PeriwalPratham/VectorX/About Team/Swasti Kedia.md

# Swasti Kedia

<p align="center">
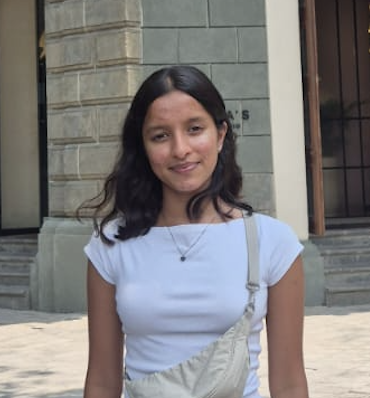
[picture p26: About Team/Swasti Kedia.png]
Swasti Kedia
  
</p>

## About Me
I am a 14-year old, Class 10 student at Podar International School, Powai (CBSE). I enjoy playing the piano, practicing martial arts, reading books, running & exploring new fields. I love building things & doing hands-on work, which led me to robotics.

**Role -** Code Lead
