PeriwalPratham/VectorX/About Team/Inaaya Sood.md

 # Inaaya Sood

<p align="center">
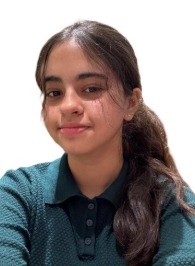
[picture p27: About Team/Inaaya Sood.png]
Inaaya Sood
  
</p>

## About Me
I am a **14-year-old Class 9 student** at **SVKM JV Parekh International School** with a strong passion for **robotics, programming, and engineering**. I enjoy **reading, coding, painting, and 3D designing**, and I am always eager to explore new technologies and develop innovative solutions.

I love experimenting with new code, building hands-on projects, and transforming ideas into functional designs. Whether I am programming autonomous robots, creating CAD models, or solving engineering challenges, I enjoy combining creativity with logical thinking to design practical and efficient solutions.

I believe that every project is an opportunity to learn something new, and I am constantly looking for ways to improve my technical skills and broaden my understanding of robotics and automation.

**Role -** Computer Vision Lead
