PeriwalPratham/VectorX/Cad/cad-iteration1.jpeg

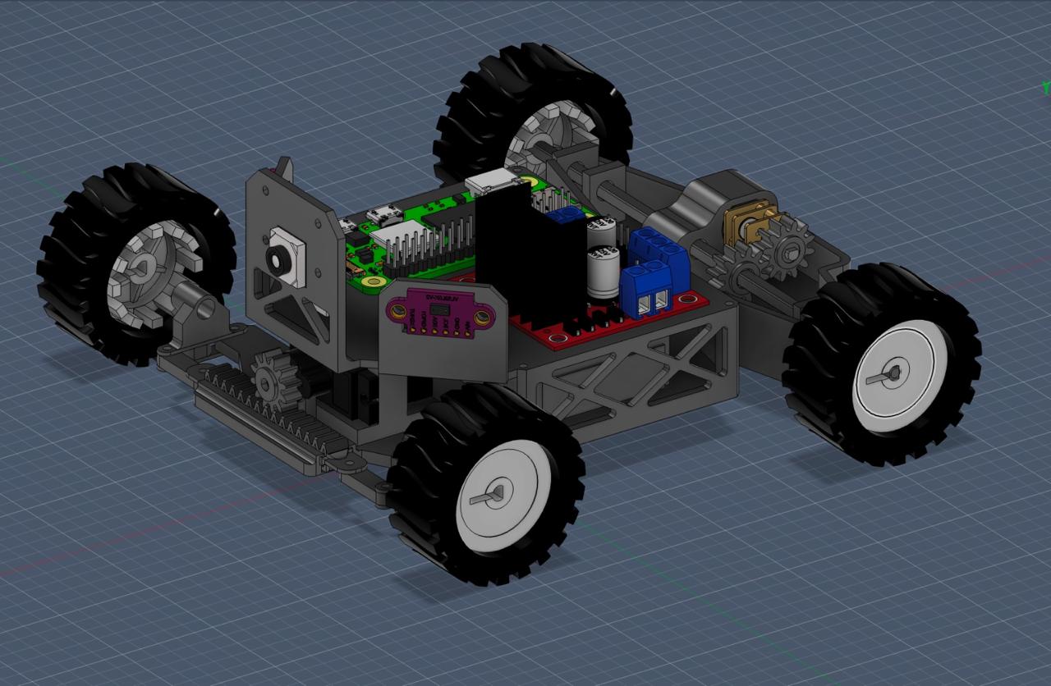
Cad/cad-iteration1.jpeg
