PeriwalPratham/VectorX/Cad/cad-iteration2.jpeg

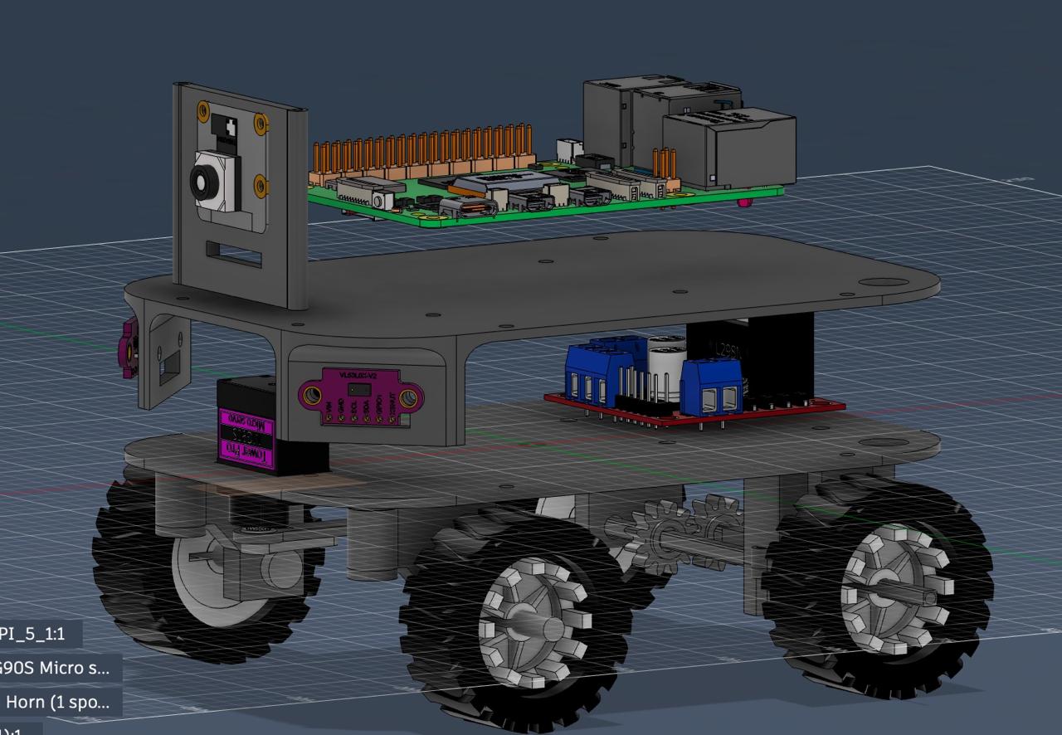
Cad/cad-iteration2.jpeg
