PeriwalPratham/VectorX/Cad/cad-iteration4.jpg

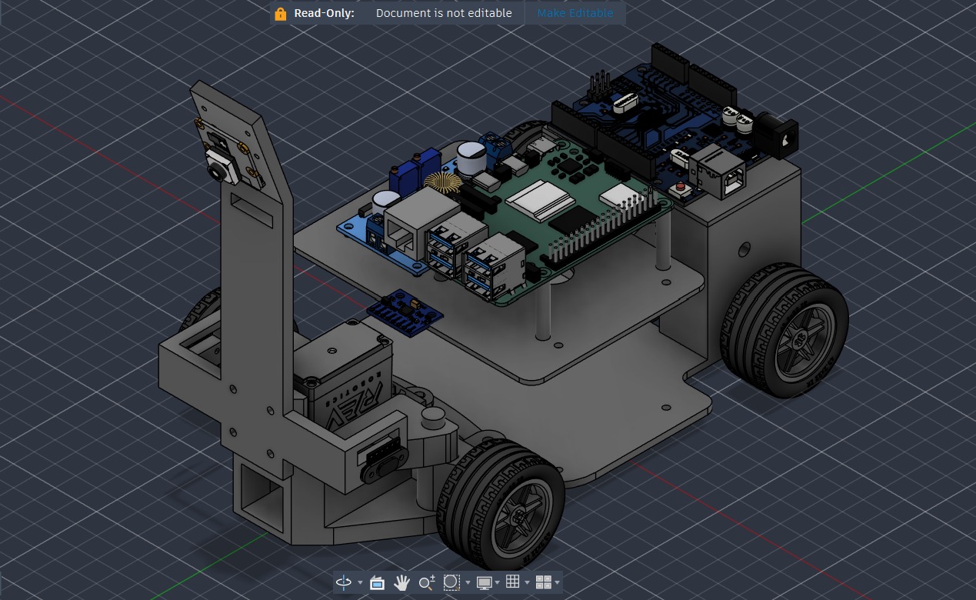
Cad/cad-iteration4.jpg
