PeriwalPratham/VectorX/Cad/cad-iteration4.png

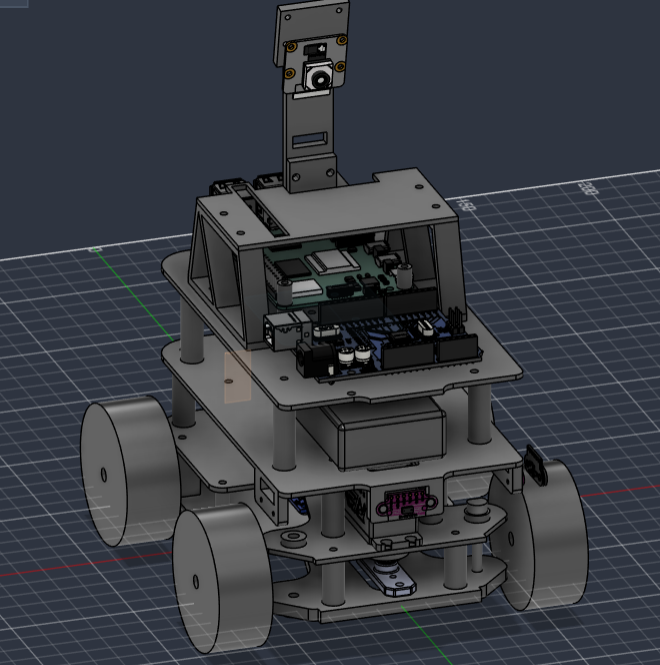
Cad/cad-iteration4.png
