PeriwalPratham/VectorX/Robot Photos/Back View APAC.png

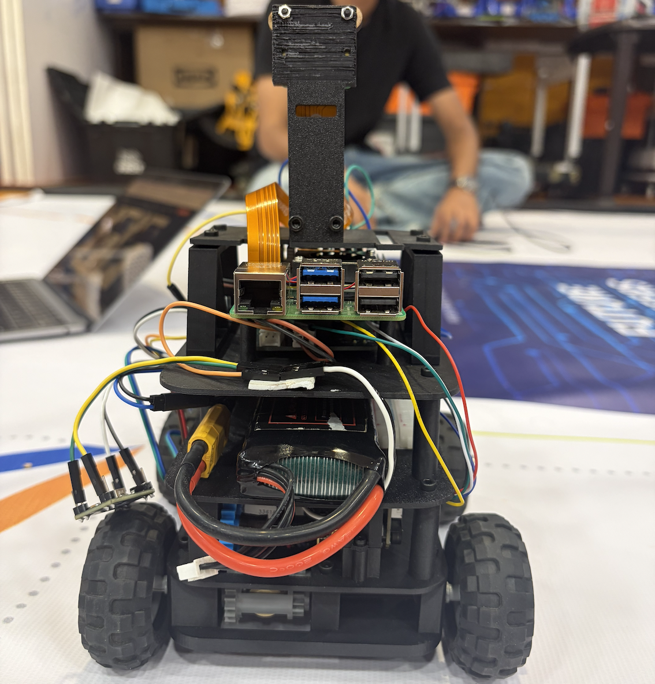
Robot Photos/Back View APAC.png
