PeriwalPratham/VectorX/Robot Photos/Bottom View APAC.png

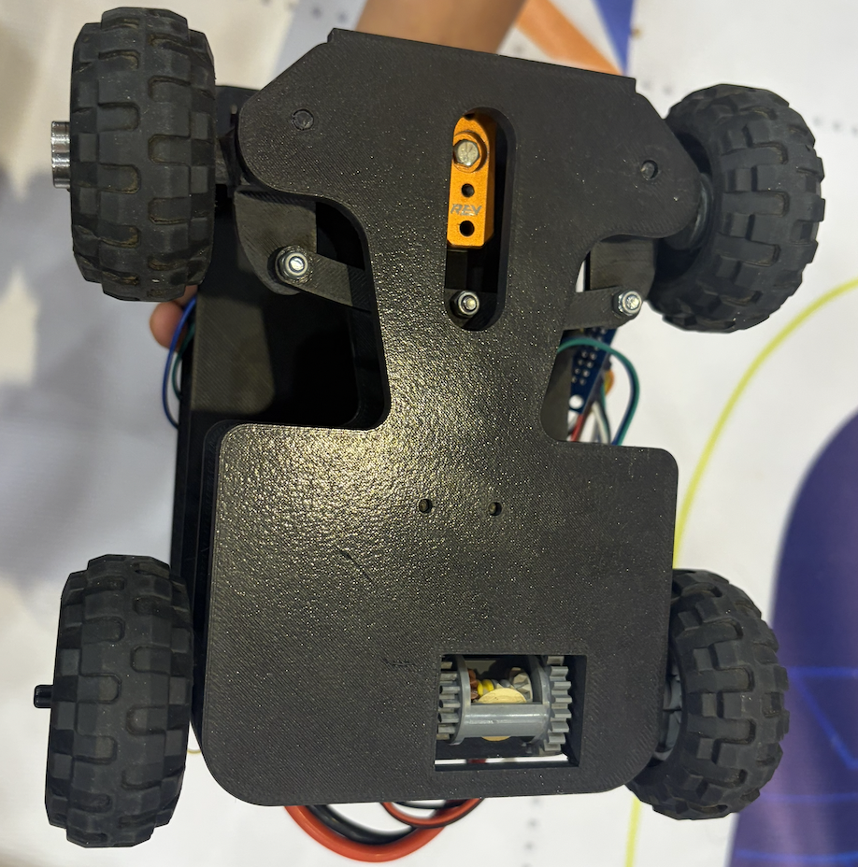
Robot Photos/Bottom View APAC.png
