PeriwalPratham/VectorX/Robot Photos/Front View APAC.png

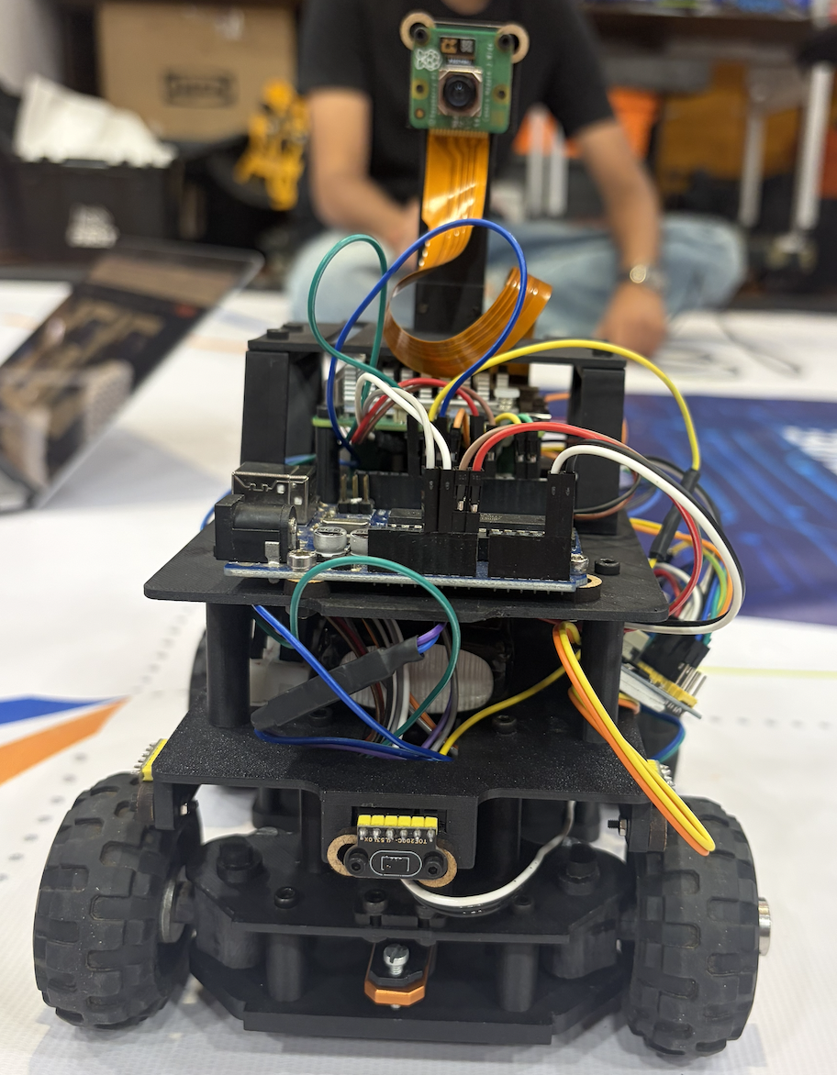
Robot Photos/Front View APAC.png
