PeriwalPratham/VectorX/Robot Photos/Left View APAC.png

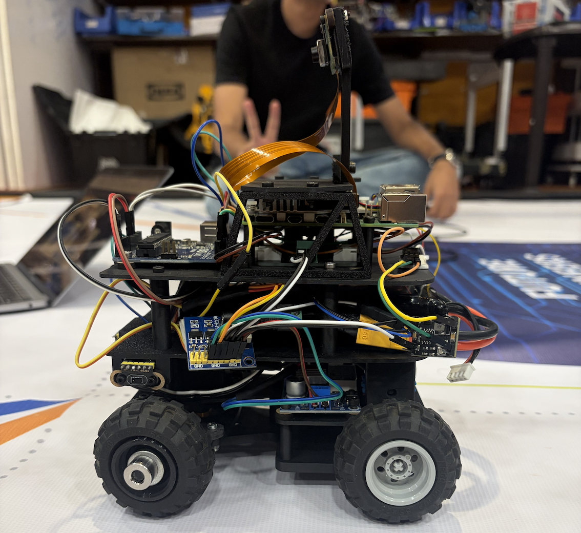
Robot Photos/Left View APAC.png
