PeriwalPratham/VectorX/Robot Photos/Right View APAC.png

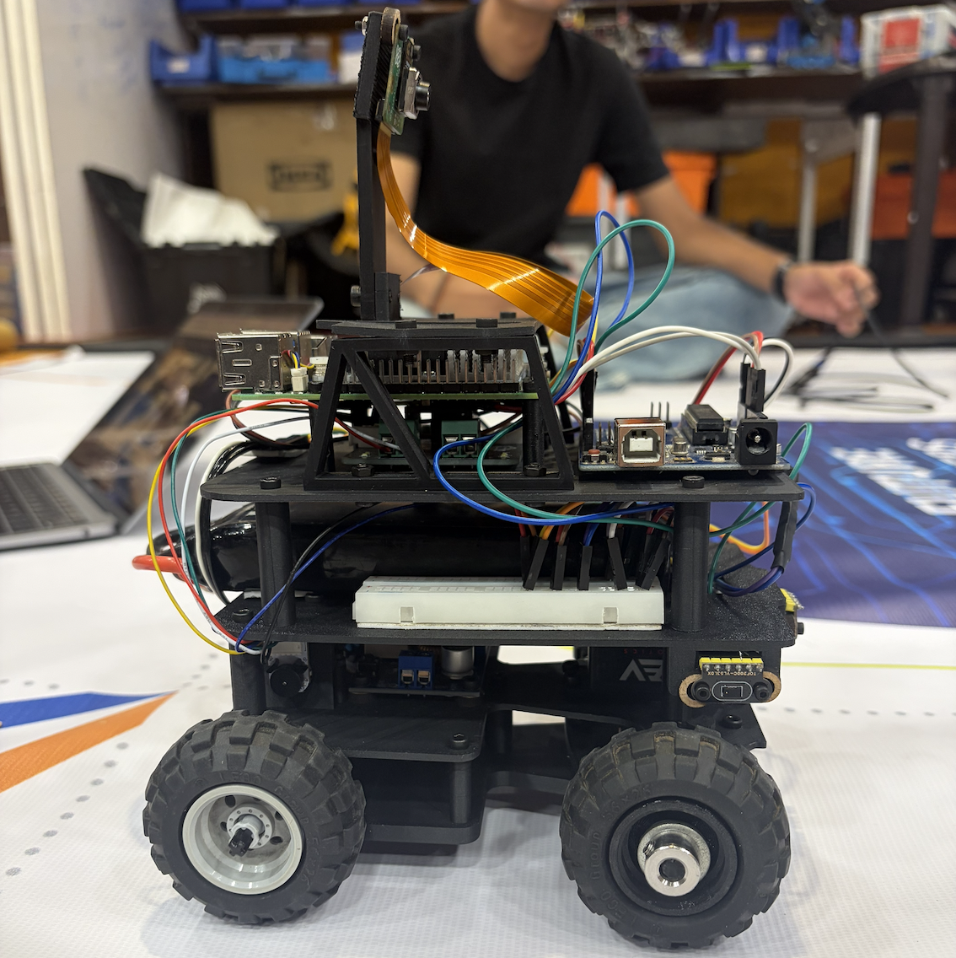
Robot Photos/Right View APAC.png
