PeriwalPratham/VectorX/Robot Photos/Top View APAC.png

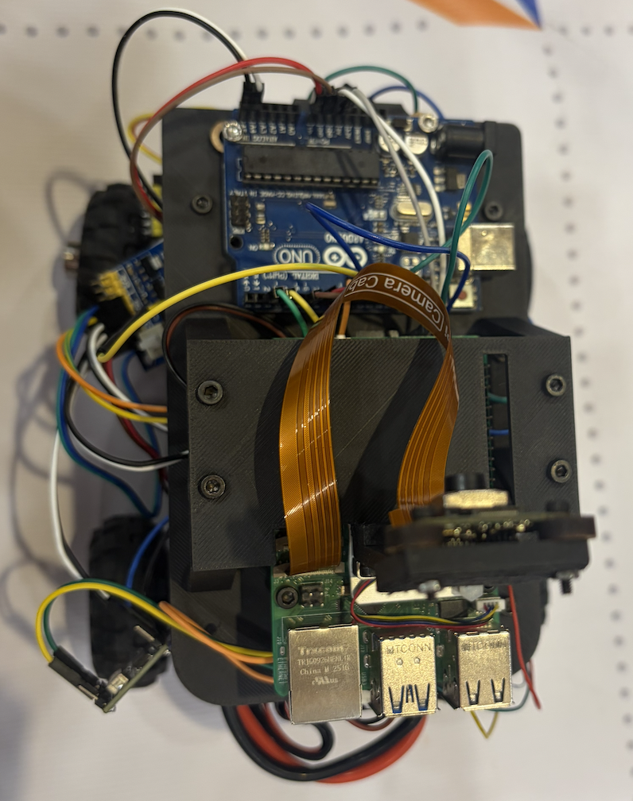
Robot Photos/Top View APAC.png
