PeriwalPratham/VectorX/Hardware/Components.md

# Hardware Components

> **Status:** Planned (subject to change during development)

## Planned Robot Dimensions

| Parameter | Planned Size |
|---|---|
| Length | 18–20 cm |
| Width | 15–17 cm |
| Height | TBD |

## Planned Components

### Image Processing
- Raspberry Pi 5
- Raspberry Pi Camera Module (model TBD)

### Microcontroller - Motor Control & Sensors
- ESP32 / Arduino / Seeeduino (final controller to be decided)

### Sensors
- VL53L0X Time-of-Flight (ToF) distance sensor(s)
- MPU9250 9-axis IMU
- Wheel encoders

### Actuators
- Encoder DC motors
- Servo motor (model TBD)

### Power
- 11.1–12 V battery
- Buck converter(s)

### Electronics
- Motor driver (TBD)
- Wiring and connectors
- Power distribution

### Mechanical
- Custom chassis
- Mounting brackets and fasteners

## Notes

This document lists the currently planned hardware configuration for the robot. Components and specifications may change as the design and testing process progresses.
