PeriwalPratham/VectorX/Test Code/Servo movement based on line position.jpeg

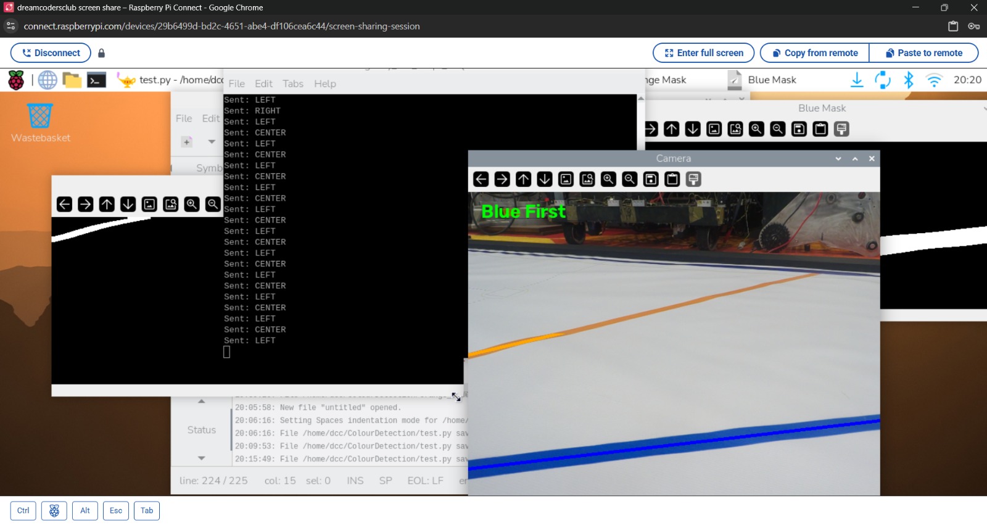
Test Code/Servo movement based on line position.jpeg
