PeriwalPratham/VectorX/(commit log)

2026-07-05 Create Servo test code.ino
2026-07-05 Create Motor test code.ino
2026-07-05 Document planned hardware components for robot
    Added detailed specifications for planned robot hardware components, including dimensions, processing units, microcontrollers, sensors, actuators, power sources, electronics, and mechanical parts.
2026-07-11 Create Servo code.ino
2026-07-11 Create Servo test code - Arduino.ino
2026-07-11 Create Servo test code - Python.py
2026-07-11 Add motor control functions and main loop logic
    Implement motor control functions for forward, backward, left, right, and stop actions. Set up servo steering and define movement logic in the loop.
2026-07-11 Add servo control and color detection python code
2026-07-11 Add servo control functionality with serial input
2026-07-11 Set up VL53L0X sensors in ToF test code
    Initialize and configure two VL53L0X sensors for distance measurement.
2026-07-19 Add MPU6050 sensor handling and heading calculation
2026-07-25 Add servo control based on serial commands
2026-07-25 Create Journey through our prototypes.md
2026-08-04 Refactor motor control parameters and logic
    Updated servo and steering angles, adjusted speed constants, and modified wall detection logic. Enhanced gyro calibration and removed unused state machine case.
2026-08-08 Update README with MPU-6050 IMU details
    Added image and specifications for MPU-6050 IMU.
2026-08-08 Update README with TOF200C sensor details
    Added details about the TOF200C distance sensor including model, type, and function.
2026-08-08 Update README with Raspberry Pi Camera details
    Added image and specifications for Raspberry Pi Camera Module 3 Wide.
2026-08-08 Add image to Motor Driver section in README
    Added an image for the Motor Driver section.
2026-08-08 Add images for Drive Motor and Servo Motor
    Added images for motor and servo motor sections in README.
2026-08-08 Add images for Arduino Uno and sensor in README
    Added images of Arduino Uno and a sensor to the README.
2026-08-09 Edit flowchart in section 1.3
2026-08-11 Enhance README with vehicle development details
    Added detailed descriptions of the vehicle's development process and steering system selection.
2026-08-11 Enhance README with detailed servo and motor driver info
    Expanded the section on the steering system and motor driver, detailing the advantages of the Rev robotics smart servo and the TB6612FNG motor driver. Included additional images and clarified testing results for motors.
2026-08-11 Include speed calculation in README
    Added linear speed calculation for the wheel using diameter and RPM.
2026-08-12 Update README with Bill of Materials details
    Added detailed Bill of Materials (BOM) with components and costs.
2026-08-12 Enhance README with mechanical system details
    Updated the README to include detailed descriptions of the mechanical and mobility system, including chassis design, drive system, steering system, motor selection, and iterations.
2026-08-12 Enhance Power & Sensor Architecture details in README
    Expanded the Power & Sensor Architecture section with detailed explanations of the power system, distribution, and budget. Added images and clarified component selection rationale for improved understanding.
2026-08-12 Expand software architecture section in README
    Added detailed software architecture section including overview, structure, modules, control flow, architecture, communication protocols, and dependencies for both Raspberry Pi and Arduino.
2026-08-12 Add servo test code for automatic and manual control
2026-08-12 Add camera test script using Picamera2 and OpenCV
2026-08-12 Add HSV calibration script for camera input
2026-08-12 Add Pink Plate Parking Detection Script
2026-08-12 Create Orange And blue track marker detection
2026-08-12 Create Orange And Blue Track Direction
2026-08-12 Add servo test code with automatic and manual control
    This code tests the servo motor by moving it to predefined angles automatically and allows manual control via serial input.
2026-08-12 Cad files
2026-08-12 more cad
2026-08-12 Update and rename Orange And blue track marker detection to orange_blue_marker.py
2026-08-23 Replace wiring images in README
    Updated wiring diagrams and images in the README.
